TiaTaiT/GSM_Alarm_Receiver/GSMreceiver.kicad_pcb

## KiCad design GSMreceiver.kicad_pcb (2026-10-26)

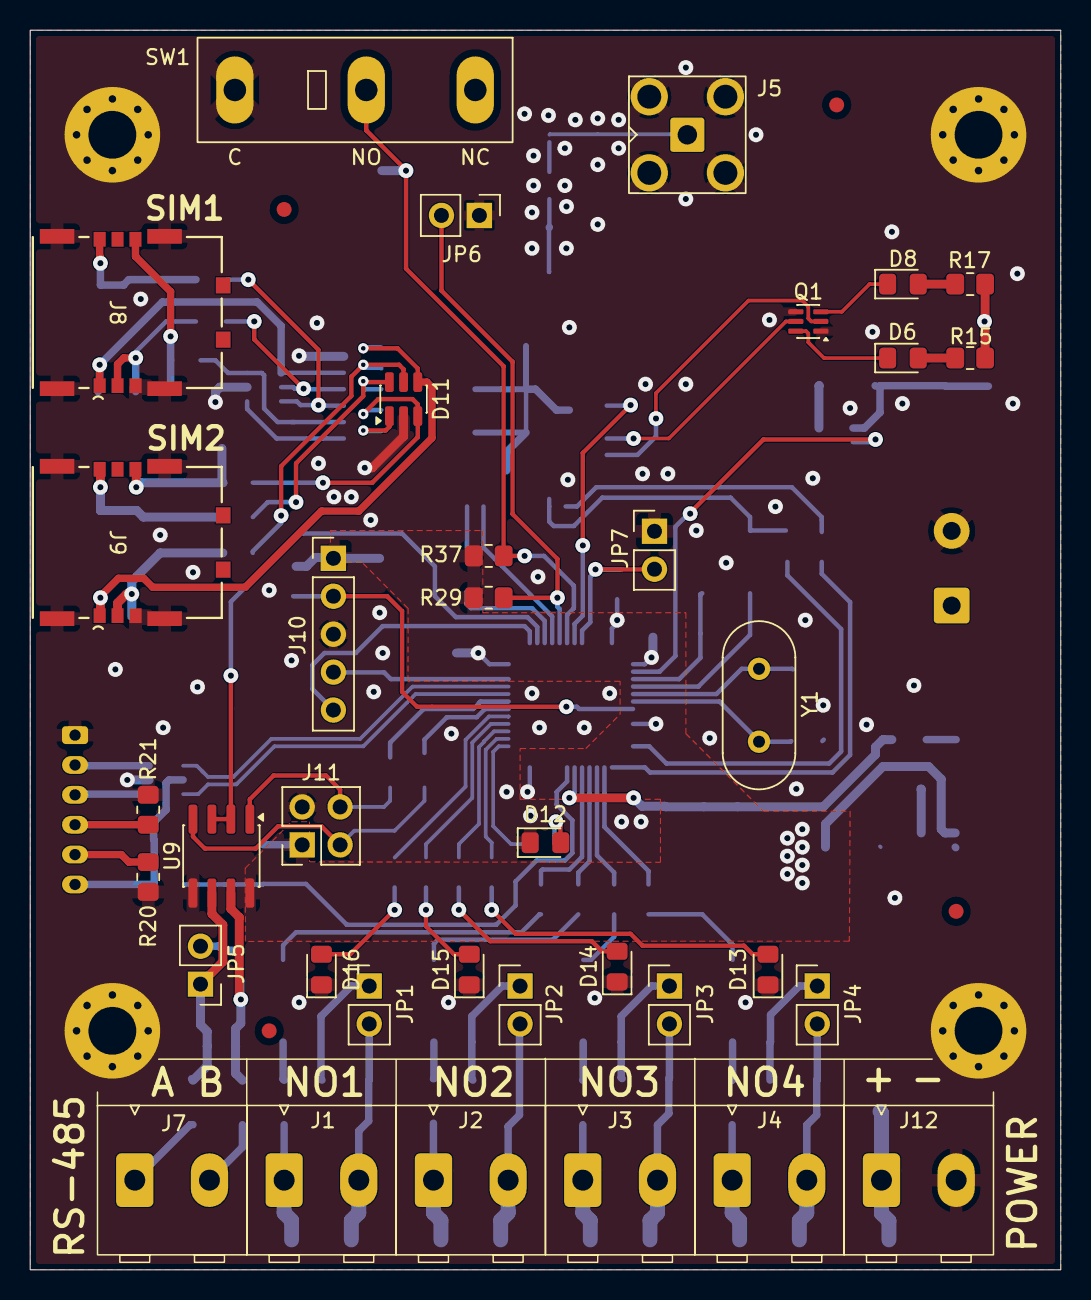
[picture p1: board GSMreceiver.kicad_pcb from above]

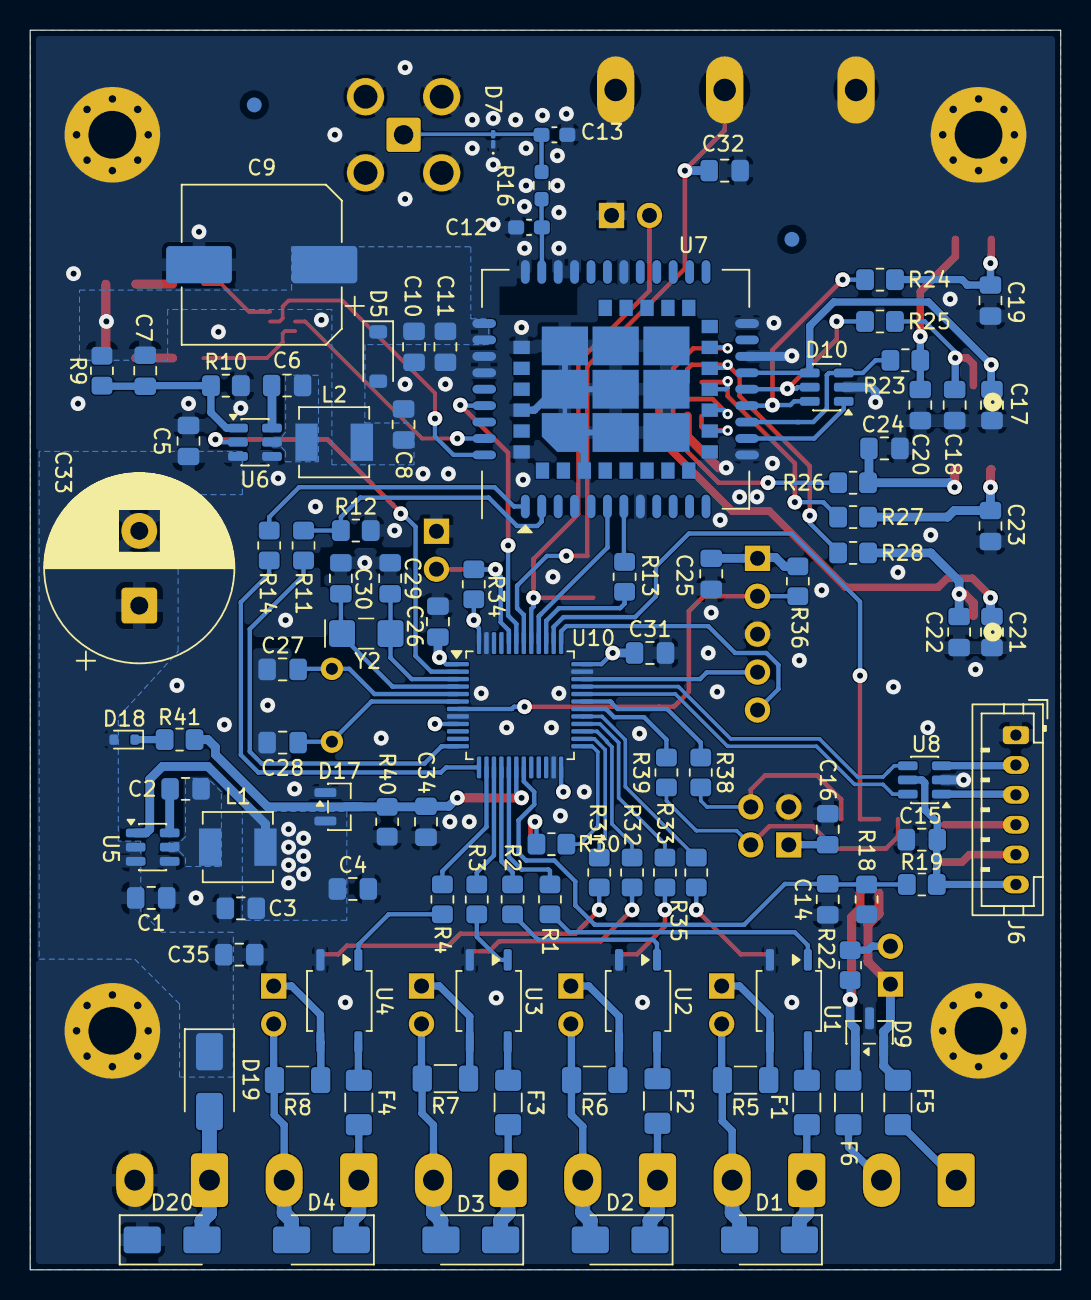
[picture p2: board GSMreceiver.kicad_pcb from below]

Board: 2 copper layers, 69.0 x 83.0 mm, 147 parts (103 on the bottom side), 107 nets.

Parts:
C1, C5: 10uF; C_0805_2012Metric_Pad1.18x1.45mm_HandSolder
C2, C6, C8, C14, C15, C16, C17, C21, C25, C26, C31, C32, C34: 100nF; C_0805_2012Metric_Pad1.18x1.45mm_HandSolder
C3, C4: 22uF; C_0805_2012Metric_Pad1.18x1.45mm_HandSolder
C7: 100pF; C_0805_2012Metric_Pad1.18x1.45mm_HandSolder
C9: 1000uF x 10V; CP_Elec_10x10.5
C10: 10pF; C_0805_2012Metric_Pad1.18x1.45mm_HandSolder
C11: 33pF; C_0805_2012Metric_Pad1.18x1.45mm_HandSolder
C12, C13: 10pF; C_0603_1608Metric_Pad1.08x0.95mm_HandSolder
C18, C19, C20, C22, C23, C24: 22pF; C_0805_2012Metric_Pad1.18x1.45mm_HandSolder
C27, C28: 20pF; C_0805_2012Metric_Pad1.18x1.45mm_HandSolder
C29, C30: 12.5pF; C_0805_2012Metric_Pad1.18x1.45mm_HandSolder
C33: 1000uFx35V; CP_Radial_D12.5mm_P5.00mm
C35: 470nFx50V; C_0805_2012Metric_Pad1.18x1.45mm_HandSolder
D1, D2, D3, D4, D20: SMAJ30CA; D_SMA
D5: MMSZ5231BT1G; D_SOD-123
D6: STATUS; LED_0805_2012Metric_Pad1.15x1.40mm_HandSolder
D7: LXES1UTAA1-157; D_01005_0402Metric_Pad0.57x0.30mm_HandSolder
D8: NETLIGHT; LED_0805_2012Metric_Pad1.15x1.40mm_HandSolder
D9: SM712-02HTG; SOT-23
D10, D11: ESDA6V1-5SC6; SOT-23-6
D12: FYLS-0805SRC; LED_0805_2012Metric_Pad1.15x1.40mm_HandSolder
D13, D14, D15, D16: FYLS-0805GC; LED_0805_2012Metric_Pad1.15x1.40mm_HandSolder
D17: BAS40-04; SOT-23
D18: 1N4148WT; D_SOD-523
D19: SS26; D_SMA
F1, F2, F3, F4, F5, F6: 1206L005/60WR; Fuse_1206_3216Metric_Pad1.42x1.75mm_HandSolder
FID1, FID2, FID3, FID4, FID5, FID6: Fiducial; Fiducial_1mm_Mask2mm
H1, H2, H3, H4: MountingHole_Pad; MountingHole_3.2mm_M3_Pad_Via
J1: Relay_1; DEGSON_DG390-5.0-02P_1x02_P5.0mm_Vertical
J2: Relay_2; DEGSON_DG390-5.0-02P_1x02_P5.0mm_Vertical
J3: Relay_3; DEGSON_DG390-5.0-02P_1x02_P5.0mm_Vertical
J4: Relay_4; DEGSON_DG390-5.0-02P_1x02_P5.0mm_Vertical
J5: RF Antenna; SMA_HJ-SMA405
J6: USB-C; JST_PH_B6B-PH-K_1x06_P2.00mm_Vertical
J7: RS485; DEGSON_DG390-5.0-02P_1x02_P5.0mm_Vertical
J8, J9: 1042240820; 1042240820_MOLEX
J10: SWD; PinHeader_1x05_P2.54mm_Vertical
J11: UART1; PinSocket_2x02_P2.54mm_Vertical
J12: DG390-5.0-02P; DEGSON_DG390-5.0-02P_1x02_P5.0mm_Vertical
JP1, JP2, JP3, JP4, JP5, JP6, JP7: Jumper_2_Open; PinHeader_1x02_P2.54mm_Vertical
L1: CSAB0420-3R3M; CSAB0420-4.4x4.4mm
L2: CSAB0420-100M; CSAB0420-4.4x4.4mm
Q1: MUN5233DW1; SOT-363_SC-70-6
R1, R2, R3, R4: 2.7k; R_0805_2012Metric_Pad1.20x1.40mm_HandSolder
R5, R6, R7, R8: 4.7k; R_1206_3216Metric_Pad1.30x1.75mm_HandSolder
R9: 205k; R_0805_2012Metric_Pad1.20x1.40mm_HandSolder
R10: 51k; R_0805_2012Metric_Pad1.20x1.40mm_HandSolder
R11, R13, R14: 1k; R_0805_2012Metric_Pad1.20x1.40mm_HandSolder
R12: 5.6k; R_0805_2012Metric_Pad1.20x1.40mm_HandSolder
R15, R17: 470; R_0805_2012Metric_Pad1.20x1.40mm_HandSolder
R16: 0; R_0603_1608Metric_Pad0.98x0.95mm_HandSolder
R18: 47k; R_0805_2012Metric_Pad1.20x1.40mm_HandSolder
R19, R29, R34, R36, R37, R40: 100k; R_0805_2012Metric_Pad1.20x1.40mm_HandSolder
R20, R21: 5.1k; R_0805_2012Metric_Pad1.20x1.40mm_HandSolder
R22: 120; R_0805_2012Metric_Pad1.20x1.40mm_HandSolder
R23, R24, R25, R26, R27, R28, R38, R39: 51; R_0805_2012Metric_Pad1.20x1.40mm_HandSolder
R30: 510; R_0805_2012Metric_Pad1.20x1.40mm_HandSolder
R31, R32, R33, R35: 330; R_0805_2012Metric_Pad1.20x1.40mm_HandSolder
R41: 1M; R_0805_2012Metric_Pad1.20x1.40mm_HandSolder
SW1: SM5-180UP-1; SW_XKB_SM5-180UP-1
U1, U2, U3, U4: PRAB34S; SOP-4_3.8x4.1mm_P2.54mm
U5: AP63203WU; TSOT-23-6
U6: AP63200WU; TSOT-23-6
U7: SIM800C-DS; SIMCom_SIM800C-DS
U8: USBLC6-2SC6; SOT-23-6
U9: XR3072XIDTR-F; SOIC-8_3.9x4.9mm_P1.27mm
U10: STM32L072CBT6; LQFP-48_7x7mm_P0.5mm
Y1: 4 MHz; Crystal_HC49-4H_Vertical
Y2: 32768 kHz; Crystal_SMD_EuroQuartz_EQ161-2Pin_3.2x1.5mm_HandSoldering

Connections:
+3V3: C3.2, C4.2, C16.2, C25.2, C26.2, C31.1, D17.2, J10.1, J11.1, L1.2, R29.1, R34.1, R36.1, R37.1, U5.1 (FB), U9.8 (VCC), U10.1 (VDD), U10.9 (VDDA), U10.24 (VDD), U10.36 (VDD_USB), U10.48 (VDD)
+4V: C7.2, C8.2, C9.1, C10.2, C11.2, D5.1 (K), L2.2, R9.2, R15.1, R17.1, U7.34 (VBAT), U7.35 (VBAT)
/4V_ENABLE: U6.2 (EN), U10.2 (PC13)
/BATTERY_LEVEL: C34.2, D17.3, R40.1, R41.1, U10.18 (PB0)
/DOUT1: R1.1, U10.17 (PA7)
/DOUT2: R2.1, U10.16 (PA6)
/DOUT3: R3.1, U10.15 (PA5)
/DOUT4: R4.1, U10.14 (PA4)
/IN_OUT/RELAY1A: D1.2 (A2), J1.2, JP1.2 (B), R5.2
/IN_OUT/RELAY1B: D1.1 (A1), F1.2, J1.1
/IN_OUT/RELAY2A: D2.2 (A2), J2.2, JP2.2 (B), R6.2
/IN_OUT/RELAY2B: D2.1 (A1), F2.2, J2.1
/IN_OUT/RELAY3A: D3.2 (A2), J3.2, JP3.2 (B), R7.2
/IN_OUT/RELAY3B: D3.1 (A1), F3.2, J3.1
/IN_OUT/RELAY4A: D4.2 (A2), J4.2, JP4.2 (B), R8.2
/IN_OUT/RELAY4B: D4.1 (A1), F4.2, J4.1
/MCU/BOOT0: JP7.2 (B), R34.2, U10.44 (BOOT0)
/MCU/LED1: R30.1, U10.25 (PB12)
/MCU/LED2: R31.1, U10.26 (PB13)
/MCU/LED3: R32.1, U10.27 (PB14)
/MCU/LED4: R33.1, U10.28 (PB15)
/MCU/LED5: R35.1, U10.29 (PA8)
/MCU/NRST: J10.2, R36.2, U10.7 (NRST)
/MCU/SWCLK: J10.5, U10.37 (PA14)
/MCU/SWDIO: J10.4, U10.34 (PA13)
/MCU/TAMPER: C32.2, R37.2, SW1.2 (B), U10.42 (PB6)
/MCU/VBUS_SENSING: C14.2, R18.1, R19.1, U10.19 (PB1)
/Power_3.3V (page 3)/3V3-BST: C2.1, U5.6 (BST)
/Power_3.3V (page 3)/3V3-SW: C2.2, L1.1, U5.5 (SW)
/Power_3.3V (page 3)/VBAT_IN: C1.2, C5.2, C33.1, C35.1, D18.2 (A), D19.1 (K), U5.2 (EN), U5.3 (IN), U6.3 (IN)
/Power_4V/4V-FB: C7.1, R9.1, R10.2, U6.1 (FB)
/Power_4V/4V-SW: C6.2, L2.1, U6.5 (SW)
/Power_input/Vsupply: D19.2 (A), D20.2 (A2), J12.1
/RF_ENABLE: U7.39 (~PWRKEY), U10.43 (PB7)
/RFmodule/NETLIGHT: Q1.5 (B), U7.41 (NETLIGHT)
/RFmodule/SIM1_CLK: D10.6 (IO5), R24.1, U7.16 (SIM1_CLK)
/RFmodule/SIM1_DATA: D10.3 (IO2), R23.1, U7.15 (SIM1_DATA)
/RFmodule/SIM1_DET: D10.1 (IO1), U7.14 (SIM1_DET)
/RFmodule/SIM1_RST: D10.5 (IO4), R25.1, U7.17 (SIM1_RST)
/RFmodule/SIM1_VDD: C17.2, D10.4 (IO3), J8.S1 (VCC), U7.18 (SIM1_VDD)
/RFmodule/SIM2_CLK: D11.6 (IO5), R27.1, U7.54 (SIM2_CLK)
/RFmodule/SIM2_DATA: D11.3 (IO2), R26.1, U7.53 (SIM2_DATA)
/RFmodule/SIM2_DET: D11.1 (IO1), U7.52 (SIM2_DET)
/RFmodule/SIM2_RST: D11.5 (IO4), R28.1, U7.55 (SIM2_RST)
/RFmodule/SIM2_VDD: C21.2, D11.4 (IO3), J9.S1 (VCC), U7.56 (SIM2_VDD)
/RFmodule/STATUS: Q1.2 (B), U7.42 (STATUS)
/RS485/RS485+: F5.2, J7.1
/RS485/RS485-: F6.2, J7.2
/RS485/RS485_N: D9.1 (A1), F6.1, R22.1, U9.7 (B)
/RS485/RS485_P: D9.2 (A2), F5.1, JP5.1 (A), U9.6 (A)
/RS485_EN: U9.2 (~RE), U9.3 (DE), U10.38 (PA15)
/SIMcard1/CARD_CLK: C19.2, J8.S3 (CLK), R24.2
/SIMcard1/CARD_DATA: C20.2, J8.S6 (I/O), R23.2
/SIMcard1/CARD_RST: C18.2, J8.S2 (RST), R25.2
/SIMcard2/CARD_CLK: C23.2, J9.S3 (CLK), R27.2
/SIMcard2/CARD_DATA: C24.2, J9.S6 (I/O), R26.2
/SIMcard2/CARD_RST: C22.2, J9.S2 (RST), R28.2
/UART1_RX: J11.4, R38.2, U9.1 (RO)
/UART1_TX: J11.2, R39.2, U9.4 (DI)
/UART2_DTR: U7.6 (UART1_DTR), U10.40 (PB4)
/UART2_RI: R13.1, U10.39 (PB3)
/UART2_RX: R14.1, U10.13 (PA3)
/UART2_TX: R11.1, U10.12 (PA2)
/USB/USB_CC1: J6.5, R20.1
/USB/USB_CC2: J6.4, R21.1
/USB/USB_N: J6.3, U8.1 (I/O1)
/USB/USB_P: J6.2, U8.3 (I/O2)
/USB/USB_VBUS: C15.2, J6.6, R19.2, U8.5 (VBUS)
/USB_D+: U8.4 (I/O2), U10.33 (PA12)
/USB_D-: U8.6 (I/O1), U10.32 (PA11)
GNDD: C1.1, C3.1, C4.1, C5.1, C8.1, C9.2, C10.1, C11.1, C12.1, C13.1, C14.1, C15.1, C16.1, C17.1, C18.1, C19.1, C20.1, C21.1, C22.1, C23.1, C24.1, C25.1, C26.1, C27.1, C28.1, C29.1, C30.1, C31.2, C32.1, C33.2, C34.1, C35.2, D5.2 (A), D7.1 (A1), D9.3 (common), D10.2 (GND), D11.2 (GND), D12.1 (K), D13.1 (K), D14.1 (K), D15.1 (K), D16.1 (K), D17.1, D20.1 (A1), H1.1 (1_1), H2.1 (1_1), H3.1 (1_1), H4.1 (1_1), J5.2 (Ext), J6.1, J8.G (SH), J8.S4 (GND), J9.G (SH), J9.S4 (GND), J10.3, J11.3, J12.2, JP6.1 (A), JP7.1 (A), Q1.1 (E), Q1.4 (E), R10.1, R12.1, R18.2, R20.2, R21.2, R40.2, SW1.1 (A), U1.2 (C), U2.2 (C), U3.2 (C), U4.2 (C), U5.4 (GND), U6.4 (GND), U7.8 (GND), U7.13 (GND), U7.19 (GND), U7.21 (GND), U7.27 (GND), U7.30 (GND), U7.31 (GND), U7.33 (GND), U7.36 (GND), U7.37 (GND), U7.45 (GND), U7.63 (GND), U7.66 (GND), U7.68 (GND), U7.69 (GND), U7.70 (GND), U7.71 (GND), U7.72 (GND), U7.73 (GND), U7.74 (GND), U7.75 (GND), U7.76 (GND), U7.77 (GND), U8.2 (GND), U9.5 (GND), U10.8 (VSSA), U10.23 (VSS), U10.35 (VSS), U10.47 (VSS)
unnamed: D6.2 (A), R15.2
unnamed: D6.1 (K), Q1.6 (C)
unnamed: C13.2, D7.2 (A2), J5.1 (In), R16.2
unnamed: D8.2 (A), R17.2
unnamed: D8.1 (K), Q1.3 (C)
unnamed: D12.2 (A), R30.2
unnamed: D13.2 (A), R31.2
unnamed: D14.2 (A), R32.2
unnamed: D15.2 (A), R33.2
unnamed: D16.2 (A), R35.2
unnamed: D18.1 (K), R41.2
unnamed: JP1.1 (A), R5.1, U1.3 (VCC)
unnamed: JP2.1 (A), R6.1, U2.3 (VCC)
unnamed: JP3.1 (A), R7.1, U3.3 (VCC)
unnamed: JP4.1 (A), R8.1, U4.3 (VCC)
unnamed: JP5.2 (B), R22.2
unnamed: JP6.2 (B), R29.2, U10.41 (PB5)
unnamed: R1.2, U1.1 (A)
unnamed: F1.1, U1.4 (VEE)
unnamed: R2.2, U2.1 (A)
unnamed: F2.1, U2.4 (VEE)
unnamed: R3.2, U3.1 (A)
unnamed: F3.1, U3.4 (VEE)
unnamed: R4.2, U4.1 (A)
unnamed: F4.1, U4.4 (VEE)
unnamed: C6.1, U6.6 (BST)
unnamed: C12.2, R16.1, U7.32 (GSM_ANT)
unnamed: R13.2, U7.7 (UART1_RI)
unnamed: R11.2, R12.2, U7.2 (UART1_RXD)
unnamed: R14.2, U7.1 (UART1_TXD)
unnamed: R39.1, U10.30 (PA9)
unnamed: R38.1, U10.31 (PA10)
unnamed: C29.2, U10.3 (PC14), Y2.2
unnamed: C30.2, U10.4 (PC15), Y2.1
unnamed: C27.2, U10.5 (PH0), Y1.2
unnamed: C28.2, U10.6 (PH1), Y1.1
