TiaTaiT/GSM_Alarm_Receiver/(commit log)

2025-04-16 USB pinout fixed
    [GSMreceiver.kicad_pcb, interface.kicad_sch]
2025-07-28 Minor changes in PCB for manufacturing
    [GSMreceiver.kicad_pcb]
2025-11-07 DEGSON f.mask pad fixed
    [GSMreceiver.kicad_pcb]
2026-03-19 Move to SIM800C-DS and two SIM
    [GSMreceiver.kicad_pcb, GSMreceiver.kicad_sch, IN_OUT.kicad_sch, MCU.kicad_sch, PowerSupply.kicad_sch, Power_input.kicad_sch, RS485.kicad_sch, SIMcard.kicad_sch]
2026-03-21 Kicad 10 update
    [GSMreceiver.kicad_pcb, GSMreceiver.kicad_sch, IN_OUT.kicad_sch, MCU.kicad_sch, PowerSupply.kicad_sch, Power_4V.kicad_sch, Power_input.kicad_sch, RS485.kicad_sch]
2026-03-21 Fiducial position move to the observable area
    [GSMreceiver.kicad_pcb]
2026-03-24 Release candidate
    [GSMreceiver.kicad_pcb, GSMreceiver.kicad_sch, IN_OUT.kicad_sch, MCU.kicad_sch, PowerSupply.kicad_sch, Power_4V.kicad_sch, Power_input.kicad_sch, RS485.kicad_sch]
2026-04-10 Proproduction version
    [GSMreceiver.kicad_pcb, GSMreceiver.kicad_sch, IN_OUT.kicad_sch, MCU.kicad_sch, Power_input.kicad_sch, RS485.kicad_sch, SIMcard.kicad_sch, USB.kicad_sch]
2026-07-10 Dual SIM version
    [GSMreceiver.kicad_pcb, IN_OUT.kicad_sch, MCU.kicad_sch, Power_input.kicad_sch, RS485.kicad_sch, SIMcard.kicad_sch, USB.kicad_sch, ideal_diode.kicad_sch]
2026-07-10 remove unused file
    [ideal_diode.kicad_sch]
2026-08-05 Silk layers minor fixes
    [GSMreceiver.kicad_pcb]
2026-10-26 USB connector inversion fix
